yaohaoying-source/FreeRTOS-Weather-Station/docs/可靠性测试.md

# 可靠性测试记录

本文区分 **主机模拟** 和 **STM32 实板测试**。主机测试通过不等于真实模块、网络或长期运行已经通过。

## 1. 本次主机模拟

测试日期：2026-11-09。使用工程源码、虚拟串口和模拟队列；OneNET 主题使用占位值。

| 项目 | 模拟结果 | 覆盖内容 |
| --- | --- | --- |
| 属性和事件报文 | 通过 | 四组传感器 16 种有效/失效组合、缓冲区截断、事件 JSON |
| 平台回执 | 通过 | 主题和 ID 匹配、错误码、先回执后 OK、超时及计时回绕 |
| AT 和 DMA 接收 | 通过 | 无应答超时、已有旧 OK、异常回调、重启 DMA、超长行、重复发命令和其他任务访问 |
| 网络连接 | 通过 | 事件订阅失败、已有连接处理、状态行加 OK、状态查询超时 |
| 下发和队列 | 通过 | 下发与回执交错、下发队列满、离线丢弃旧下发 |
| 事件队列 | 通过 | 模拟容量 4、第五条丢弃计数、超时保留、延迟重试、成功回执后出队 |

上表中的队列和串口是测试桩；它不覆盖真实 DMA 时序、无线网络或 MCU 内存余量。

### 主机模拟的复现情况

上述模拟当时在 Windows 使用 Python 3.12.4、llvmlite 0.42.0 和 Keil Arm Compiler 6.22，从工程源码生成 LLVM IR 后运行。原测试脚本及测试桩已从当前仓库移除；此处保留历史结果，当前版本不能直接重复运行该组主机模拟。

## 2. Watch 观察量

任务栈的单位是 **word**，本工程 1 word = 4 字节；这些值是任务运行以来的历史最小剩余量，不是已用量。

| Watch 变量 | 含义 | 该任务分配的栈 |
| --- | --- | ---: |
| `g_stack_start_min_words` | 启动任务删除前测得的历史最小剩余 | 128 words / 512 B |
| `g_stack_sensor_min_words` | 采集任务历史最小剩余 | 384 words / 1536 B |
| `g_stack_display_min_words` | 显示任务历史最小剩余 | 512 words / 2048 B |
| `g_stack_network_min_words` | 网络任务历史最小剩余 | 512 words / 2048 B |
| `g_stack_idle_min_words` | 空闲任务历史最小剩余 | 128 words / 512 B |
| `g_heap_free_bytes` | FreeRTOS 堆当前空闲字节 | 配置总量 10240 B |
| `g_heap_min_free_bytes` | FreeRTOS 堆历史最小空闲字节 | 配置总量 10240 B |

例如读到 `g_stack_network_min_words = 100`，表示已覆盖的运行场景中历史最小剩余约 `100 × 4 = 400 B`。水位值依赖实际执行路径和写入情况，不能单凭一次正常运行就证明栈永远足够。FreeRTOS 任务栈通过其堆分配，不能把两者的已用量重复相加；中断使用的主栈也不包含在上述任务栈观察值中。启动任务会删除，因此只在删除前记录。

其他观察量：

- `g_air_recovery_attempts`：连接尝试次数，包含首次连接和恢复尝试。
- `g_air_reconnect_count`：在线状态转入恢复的次数。
- `g_air_at_failures`、`g_air_upload_timeouts`：AT 失败次数、属性回执超时次数。
- `g_air_uart_error_count`、`g_air_rx_restart_count`、`g_air_command_collision_count`：串口错误、接收重启和 AT 访问冲突次数。
- `g_cloud_set_received`、`g_cloud_set_applied`、`g_cloud_set_overflow`、`g_cloud_set_discarded`：属性下发接收、应用、队列满和恢复时丢弃次数。
- `g_pm25_event_queued`、`g_pm25_event_success`、`g_pm25_event_dropped`：超限事件入队、收到成功回执、队列满丢弃次数。
- `g_air_line_overflow`：超过单行容量时整行丢弃的次数；它**不代表** DMA 缓冲区覆盖次数。

## 3. 实板测试清单

以下按实际进度记录；未完成的场景仍需实测。每次记录开始和结束时间、供电方式、现象和 Watch 变量；不要把空白项写成通过。

| 测试 | 操作和预期 | 实际结果 |
| --- | --- | --- |
| 上电基线 | 正常上电；OLED 轮转，OneNET 周期更新；记录各栈水位和堆水位 | 部分确认：OLED 和 OneNET 上传正常，栈堆快照已记录；启动条件及运行时长待确认 |
| 单传感器失效 | 全部断电后移除 DHT11，再上电；温湿度本轮不上传，其他有效字段继续更新。断电后恢复接线并重新上电 | 通过（用户反馈，详细报文和时间未提供） |
| BMP280 断开与恢复 | 断电移除 BMP280 再上电，检查 OLED、其他数据及上报；断电接回后检查气压恢复 | 通过（用户反馈，详细报文和时间未提供） |
| 上报与下发同时发生 | 设备在线时，在上传时刻附近连续测试阈值和蜂鸣器开关；对照平台操作结果、OLED 与 `g_cloud_set_*` | 部分通过：用户反馈上传期间阈值下发及单独的蜂鸣器开关测试正常；严格重叠待验证 |
| 无应答 | 在安全断电条件下让模块不连接，再给 STM32 上电；采集和显示仍运行，网络连接尝试按间隔继续。恢复硬件连接前先断电 | 通过：重试数 1→3，OLED 如预期；接回并重启后 MQTT HAL_OK |
| 人工触发网络恢复 | Keil Watch 置位恢复请求，观察重连和上传 | 通过（用户反馈，具体计数和耗时未提供） |
| 断网后恢复 | 可通过 OneNET 停用/启用设备模拟平台强制下线，不重启 MCU；观察重连、平台上线和恢复上报。该方法不覆盖 4G 无线失网 | 通过（用户反馈按上述步骤恢复，具体计数和耗时未提供） |
| 队列满 | 先参考上面的主机模拟；若有可控的实板事件注入手段，再记录 `g_pm25_event_dropped` 和 `g_cloud_set_overflow` | 待测 |
| 持续运行 | 先至少连续运行 2 小时，进一步可做 24 小时；记录平台数据间隔、页面、错误计数、栈和堆水位 | 2 小时通过：用户确认未重启、云端持续更新、相关计数为 0，栈和堆稳定；24 小时待测 |

OneNET 对未上报的字段可能保留上一次值；验证部分上报时，要看其他字段的更新时间或上行报文，不能只看失效字段是否还显示旧值。模拟量模块断线不一定导致 ADC 返回错误，所以不要把 ADC 的 `HAL_OK` 当作传感器完好证明。

不建议带电插拔直插模块。若 4G 模块没有接 STM32 可控 RST，模块完全死机时软件不能保证自动复位；通用 AT 响应也缺乏命令编号，静默等待和状态查询只能降低迟到回复造成的歧义。发生此类情况需要人工复位或重启供电。

## 4. 实板记录

### 2026-11-10 云端蜂鸣器开关测试

- 测试内容：按非超限条件下云端开关 ON → OFF 的步骤，观察设备状态。
- 结果：用户反馈蜂鸣器开关测试通过；具体响应、截图和声音现象未单独提供。
- 本次记录不能替代超限条件下蜂鸣器发声及事件上报的重新验证。

### 2026-11-10 BMP280 断开与恢复

- 测试内容：按断电后移除 BMP280 的步骤，观察 OLED 气压异常显示、其他数据与上报；再断电接回并观察气压恢复。
- 结果：用户反馈“没有问题”，按用户反馈本轮通过；未提供具体数据、日志或时间。
- 本次只覆盖模块缺席和重新上电恢复，不代表 I²C 总线短路或运行中异常均已通过。

### 2026-11-10 上报期间阈值下发

- 测试内容：设备在线周期上报时，按提示在上报时间附近依次下发阈值 30 和 20，观察平台应答、OLED 和相关计数。
- 结果：用户反馈“没问题”；本轮具体日志、计数值和时间未提供。
- 结论：按用户反馈，本轮上下行业务配合测试通过。手动操作不能证明下发严格发生在某一笔上报等待回执的时间窗内；蜂鸣器下发不在本轮范围内。

### 2026-11-10 平台强制下线恢复

- 测试内容：OneNET 停用后启用设备，保持 MCU 运行，观察设备重新上线和恢复上报。
- 结果：用户反馈本轮按上述步骤测试通过；具体重连计数、恢复耗时和本轮日志未提供。
- 该测试模拟平台强制断开 MQTT 会话，不覆盖 SIM 卡或 4G 无线链路失网恢复。

### 2026-11-09 连续运行 2 小时

- 用户反馈：此前要求观察的重连、串口错误和属性上传超时计数均为 0；栈和堆的观察值与之前一致。
- 结论：2 小时稳定运行测试按用户反馈通过；24 小时运行、实际无线断网恢复和实板队列满仍未测试。
- 用户确认设备在没有重启的情况下连续运行已满 2 小时，OneNET 持续更新；精确起止时间及本轮新的栈、堆截图未提供。

### 2026-11-09 4G 模块无应答

- 用户断电取下模块后重新运行：截图中 `g_air_init_status = HAL_OK`、`g_air_mqtt_status = HAL_BUSY`，`g_air_recovery_attempts` 从 1 增至 3；用户反馈 OLED 表现符合预期。
- 断电接回模块并重新上电后：截图中 `g_air_recovery_attempts = 1`、`g_air_mqtt_status = HAL_OK`。计数器重启后重新计数。
- 结论：模块缺席时能继续重试且本地显示符合预期；接回模块重新上电后 MQTT 连接成功。截图未提供独立的 UP 回执详情。
- 该测试包含 MCU 断电重启，尚不能证明同一次运行中真实断网后自动恢复。

### 2026-11-09 人工触发网络恢复

- 测试内容：设备在线时，通过 Keil Watch 将 `g_air_recovery_requested` 置为 1，触发网络恢复流程。
- 结果：用户反馈测试通过；具体计数、状态值和恢复耗时未提供。
- 本次为主动触发恢复流程，不能替代模块无应答和实际断网后恢复的测试。

### 2026-11-09 单传感器失效测试

- 测试内容：断电移除 DHT11，检查其他有效数据能否继续上报，并在断电后恢复传感器。
- 结果：用户反馈上述测试通过；具体上传报文、数值和时间未提供。
- 此结果不代表网络无应答、实际断网重连或长时间运行测试已经通过。

### 2026-11-09 云端阈值下发

- 设备正常运行时，下发 `pm25_limit = 20`；用户确认设备端阈值修改成功。
- `g_cloud_set_received` 和 `g_cloud_set_applied` 相比操作前各增加 1。
- OneNET 于 16:13:53 返回外层 `code = 0`，设备响应 `code = 200`、`id = "4"`、`msg = "success"`。
- 结论：正常运行时的阈值下发和设备回复通过。没有取得下发与某次上传严格重叠的时间证据；蜂鸣器下发当时尚未单独验证，11 月 10 日用户反馈单独测试通过。

### 2026-11-09 Keil Watch 快照

来源：用户提供的两张 Keil Watch 截图。用户确认 OLED 页面及 OneNET 数据上传正常，运行时长尚未确认；本记录不代表故障注入或长期运行通过。

| 任务 | 分配栈（word） | 截图中的最小剩余栈（十六进制） | 剩余（word） | 剩余（B） |
| --- | ---: | ---: | ---: | ---: |
| Start | 128 | `0x4C` | 76 | 304 |
| Sensor | 384 | `0x13C` | 316 | 1264 |
| Display | 512 | `0x159` | 345 | 1380 |
| NetworkTask | 512 | `0x163` | 355 | 1420 |
| Idle | 128 | `0x74` | 116 | 464 |

| FreeRTOS 堆观察量 | 十六进制 | 字节 |
| --- | ---: | ---: |
| 当前空闲 | `0x928` | 2344 |
| 历史最小空闲 | `0x6C0` | 1728 |

初步结论：本次已执行场景下未看到任务栈或堆耗尽；暂不调整栈和堆配置。任务栈高水位只覆盖已执行并写入的路径，仍需在网络故障和长时间运行中复测。

- 测试日期和固件版本：
- 开始时间 / 结束时间 / 运行时长：
- 供电方式：
- 传感器失效与恢复：
- 网络中断与恢复：
- 下发、上报及事件：
- 最小剩余栈（Start / Sensor / Display / Network / Idle，单位 word）：
- 堆当前空闲 / 历史最小空闲（单位 byte）：
- 错误、溢出或丢弃计数：
- 结论与未解决现象：
