yaohaoying-source/FreeRTOS-Weather-Station/hardware/BOM.md

# 气象站物料清单

本清单按一套设备整理，分为 PCB 板级器件、整机模块与电源、调试安装配件。板级数据来自本地嘉立创 EDA 工程中的 PCB；保留原设计标注，未据此推断实物焊接值。外接模块及配件按作者提供的信息和现有资料整理。

## 一、PCB 板级器件

共 **22 个位号，14 组器件**。原始表格见 [EDA 导出 BOM](pcb-bom.xlsx)。已按位号、数量、标称值、封装及制造商/供应商字段与本地 EDA PCB 数据逐项核对。

| 位号 | 数量 | 工程标注 / 器件 | 封装 | 制造商型号 | 供应商编号 |
| --- | ---: | --- | --- | --- | --- |
| `BEEP1` | 1 | 2300Hz | `BUZ-TH_BD12.0-P7.60-D0.6-FD` | `TMB12A03` | `C96222` |
| `C2`、`C3` | 2 | 100nF | `C0805` | `CL21B104KBCNNNC` | `C1711` |
| `C6` | 1 | 100nF | `C0805` | `CC0805KRX7R9BB104` | `C49678` |
| `CN1` | 1 | DB128V-5.08-4P-GN-S | `CONN-TH_4P-P5.08_DIBO_DB128V-5.08` | `DB128V-5.08-4P-GN-S` | `C2915641` |
| `DC1` | 1 | DC-470-2.1GP | `DC-IN-TH_DC-470-2.1GP` | `DC-470-2.1GP` | `C194407` |
| `H19`、`H24` | 2 | PM254V-11-06-H85 | `HDR-TH_6P-P2.54-V-F` | `PM254V-11-06-H85` | `C2832269` |
| `H22` | 1 | PZ254V-11-03P | `HDR-TH_3P-P2.54-V-M` | `PZ254V-11-03P` | `C2937625` |
| `H5`、`H23`、`H25` | 3 | PM2.54-1*4 | `HDR-TH_4P-P2.54-V-F` | `PM2.54-1*4` | `C5116530` |
| `H6`、`H7` | 2 | PZ254V-11-02P | `HDR-TH_2P-P2.54-V-M` | `PZ254V-11-02P` | `C492401` |
| `P1` | 1 | 2.54-1*8P母环保 | `HDR-TH_8P-P2.54-V-F-1` | `2.54-1*8P母环保` | `C27438` |
| `R1`、`R3`、`R4` | 3 | 150Ω（料号冲突，待核对） | `R0805_NEW` | `0805W8F100JT5E` | 待核对 |
| `R2` | 1 | 10Ω | `R0805_NEW` | `0805W8F100JT5E` | `C17415` |
| `U1`、`U2` | 2 | KH-2.54FH-1X20P-H8.5 | `HDR-TH_20P-P2.54-V-F-2` | `KH-2.54FH-1X20P-H8.5` | `C2905423` |
| `U5` | 1 | ULN2003G-S16-R | `SOIC-16_L9.9-W3.9-P1.27-LS6.0-BL` | `ULN2003G-S16-R` | `C73286` |

> **待核对：** 原工程中 R1、R3、R4 的标称值为 150Ω，但关联的制造商型号与标称 10Ω 的 R2 相同；该型号对应的原工程器件属性也写为 10Ω。请按原理图和实际选型确认后再采购，当前未擅自修改。C2、C3 等数值均为工程标注，实物须另行核对。

## 二、整机模块、电源与连接配件

以下按一套设备列出；这些模块、电源及配件不属于上表的 22 个 PCB 板级位号。随模块附带的天线、线束等不必重复采购。

| 物料 | 数量 | 型号或说明 |
| --- | ---: | --- |
| 气象站 PCB 裸板 | 1 | 使用本目录的硬件工程制作；板级焊接器件见上表 |
| STM32 开发板 | 1 | STM32F103C8T6 最小系统板 |
| 温湿度模块 | 1 | DHT11，单总线 |
| 气压模块 | 1 | BMP280，I²C；设备曾读取到芯片 ID 0x58 |
| 光照模块 | 1 | 光敏电阻式模块，使用 AO 模拟输出；模块和芯片具体型号待确认 |
| 粉尘模块 | 1 | GP2Y1010 系列；此前提供型号 GP2Y1010AU0F，完整实物丝印待核对 |
| OLED 显示模块 | 1 | I²C OLED；程序按 128×64 配置，面板尺寸和控制器型号待确认 |
| 4G 通信模块 | 1 | 合宙 Air780E-B AT 版，转接板丝印 VIN / GND / RXD / TXD / DTR / RST / RDY |
| 风速传感器 | 1 | 聚碳三杯式风力测量仪；具体型号、量程、供电和输出信号待核对；当前 FreeRTOS 固件尚未实现风速采集 |
| 开关电源适配器 | 1 | 12V 1A；直流插头规格、极性及负载能力以实物为准 |
| 直流降压模块 | 1 | MINI560，项目使用 12V 转 5V；用户提供的标称输出为 5V 5A。两种称呼指同一块模块，不重复计数 |
| 4G 天线及配套射频线 | 1 套 | 根据转接板实际接口选择；若模块已附带则无需重复购买 |
| 4G 物联网 SIM 卡 | 1 | 需具备可用的移动网络服务；运营商及资费按实际选择 |
| 2.54 mm 跳线帽 | 2 个 | 对应原理图中的 H6、H7 串口跳线；按实际连接方式配备 |
| 传感器及供电连接线 | 1 套 | 按粉尘、风速及电源接口的实际插头和线序配备；随模块附带的线束不重复采购 |

风速硬件已列入清单，但当前 FreeRTOS 项目暂未实现风速采集、显示、上传和风速报警；旧版参考代码位于仓库的 `legacy/wind_sensor/`。

**供电能力：** MINI560 的 5A 是用户提供的模块标称值，并不代表本项目使用 12V 1A 适配器时可以输出 5V 5A：适配器标称功率约 12W，而 5V 5A 为 25W。转换损耗和其他负载会进一步影响可用功率，整机供电余量需按实际负载核对。

## 三、调试与安装辅助（按需）

| 物料 | 数量 | 用途 |
| --- | ---: | --- |
| ST-Link 调试器、USB 线及 SWD 连接线 | 1 套 | 烧录与调试；连接线按实际接口准备，建议按接口支持情况连接 NRST 复位线 |
| 固定支柱、螺钉等 | 按需 | 固定 PCB 和模块，规格依据实际结构选择 |

## 四、使用说明

- [本地 EDA 原工程](weather-station.epro) 与 [原理图 PDF](schematic.pdf) 为原工程资料；采购及焊接前应核对实际板卡、封装、电压和模块引脚。
- PCB 板级原始 BOM 导出自已打开的 PCB 页面，22 个位号、数量、标称值、封装和料号已与本地 EDA PCB 数据比对一致；这不等于实物、原理图、供货信息均已验证。
- PM2.5 目前使用旧公式计算，属于未标定的粉尘估算值；光照输出是相对百分比，不代表经过标定的 lux。
