yaohaoying-source/FreeRTOS-Weather-Station/hardware/pcb-bom.xlsx

No. | Quantity | Comment | Designator | Footprint | Value | Manufacturer Part | Manufacturer | Supplier Part | Supplier
1 | 1 | 2300Hz | BEEP1 | BUZ-TH_BD12.0-P7.60-D0.6-FD | 2300Hz | TMB12A03 | 华能 | C96222 | LCSC
2 | 2 | 100nF | C2,C3 | C0805 | 100nF | CL21B104KBCNNNC | SAMSUNG(三星) | C1711 | LCSC
3 | 1 | 100nF | C6 | C0805 | 100nF | CC0805KRX7R9BB104 | YAGEO(国巨) | C49678 | LCSC
4 | 1 | DB128V-5.08-4P-GN-S | CN1 | CONN-TH_4P-P5.08_DIBO_DB128V-5.08 |  | DB128V-5.08-4P-GN-S | DORABO(地博电气) | C2915641 | LCSC
5 | 1 | DC-470-2.1GP | DC1 | DC-IN-TH_DC-470-2.1GP |  | DC-470-2.1GP | GANGYUAN(港源) | C194407 | LCSC
6 | 3 | PM2.54-1*4 | H5,H23,H25 | HDR-TH_4P-P2.54-V-F |  | PM2.54-1*4 | ZHOURI(洲日) | C5116530 | LCSC
7 | 2 | PZ254V-11-02P | H6,H7 | HDR-TH_2P-P2.54-V-M |  | PZ254V-11-02P | XFCN(兴飞) | C492401 | LCSC
8 | 2 | PM254V-11-06-H85 | H19,H24 | HDR-TH_6P-P2.54-V-F |  | PM254V-11-06-H85 | XFCN(兴飞) | C2832269 | LCSC
9 | 1 | PZ254V-11-03P | H22 | HDR-TH_3P-P2.54-V-M |  | PZ254V-11-03P | XFCN(兴飞) | C2937625 | LCSC
10 | 1 | 2.54-1*8P母环保 | P1 | HDR-TH_8P-P2.54-V-F-1 |  | 2.54-1*8P母环保 | BOOMELE(博穆精密) | C27438 | LCSC
11 | 3 | 150Ω | R1,R3,R4 | R0805_NEW | 150Ω | 0805W8F100JT5E | UNI-ROYAL(厚声) |  | LCSC
12 | 1 | 10Ω | R2 | R0805_NEW | 10Ω | 0805W8F100JT5E | UNI-ROYAL(厚声) | C17415 | LCSC
13 | 2 | KH-2.54FH-1X20P-H8.5 | U1,U2 | HDR-TH_20P-P2.54-V-F-2 |  | KH-2.54FH-1X20P-H8.5 | kinghelm(金航标) | C2905423 | LCSC
14 | 1 | ULN2003G-S16-R | U5 | SOIC-16_L9.9-W3.9-P1.27-LS6.0-BL |  | ULN2003G-S16-R | UTC(友顺) | C73286 | LCSC
