yaohaoying-source/FreeRTOS-Weather-Station/hardware/schematic.pdf

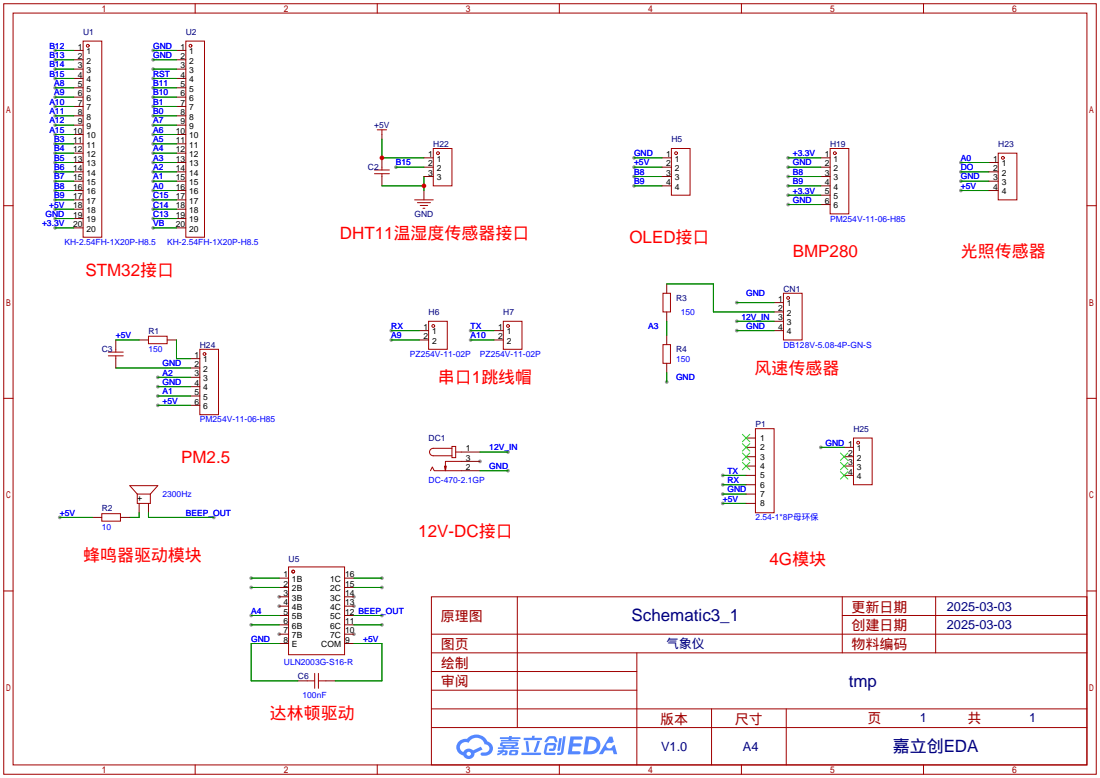
[picture p9: page 1]
