yaohaoying-source/FreeRTOS-Weather-Station/(list of files, drawings)

Other design files:
hardware/weather-station.epro
