yaohaoying-source/FreeRTOS-Weather-Station/Core/Inc/codetab.h

/**
  ******************************************************************************
  * @file    codetab.h
  * @author  fire
  * @version V1.0
  * @date    2014-xx-xx
  * @brief   128*64点阵的OLED显示测试工程，仅适用于SD1306驱动IIC通信方式显示屏
  ******************************************************************************
  * @attention  *
	* 
	* 1. 128*64点整OLED模块功能演示程序的字表，仅适用heltec.taobao.com所售产品;
	* 2. 字表由打包资料中的“取字软件”计算得出;
	* 3. 取字方式 -- 共阴、列行式、逆向输出
	*
  *
  ******************************************************************************
  */ 
#ifndef __CODETAB_H
#define	__CODETAB_H


/***************************16*16的点阵字体取模方式：共阴——列行式——逆向输出*********/

/************************************6*8的点阵************************************/
const unsigned char F6x8[][6] =
{
	0x00, 0x00, 0x00, 0x00, 0x00, 0x00,// sp
	0x00, 0x00, 0x00, 0x2f, 0x00, 0x00,// !
	0x00, 0x00, 0x07, 0x00, 0x07, 0x00,// "
	0x00, 0x14, 0x7f, 0x14, 0x7f, 0x14,// #
	0x00, 0x24, 0x2a, 0x7f, 0x2a, 0x12,// $
	0x00, 0x62, 0x64, 0x08, 0x13, 0x23,// %
	0x00, 0x36, 0x49, 0x55, 0x22, 0x50,// &
	0x00, 0x00, 0x05, 0x03, 0x00, 0x00,// '
	0x00, 0x00, 0x1c, 0x22, 0x41, 0x00,// (
	0x00, 0x00, 0x41, 0x22, 0x1c, 0x00,// )
	0x00, 0x14, 0x08, 0x3E, 0x08, 0x14,// *
	0x00, 0x08, 0x08, 0x3E, 0x08, 0x08,// +
	0x00, 0x00, 0x00, 0xA0, 0x60, 0x00,// ,
	0x00, 0x08, 0x08, 0x08, 0x08, 0x08,// -
	0x00, 0x00, 0x60, 0x60, 0x00, 0x00,// .
	0x00, 0x20, 0x10, 0x08, 0x04, 0x02,// /
	0x00, 0x3E, 0x51, 0x49, 0x45, 0x3E,// 0
	0x00, 0x00, 0x42, 0x7F, 0x40, 0x00,// 1
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
};
const unsigned char F[][16] = {
	0x70,0x88,0xF8,0x40,0xE0,0x18,0x00,0x00,0x00,0x30,0x0C,0x03,0x1E,0x21,0x3F,0x00,
	0x00,0x00,0x00,0x00,0x00,0x00,0x00,0x00,0x00,0x00,0x00,0x00,0x00,0x00,0x00,0x00/*"%",0*/
};

#endif
