yaohaoying-source/FreeRTOS-Weather-Station/Core/Src/adc.c

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
/* Includes ------------------------------------------------------------------*/
#include "adc.h"

ADC_HandleTypeDef hadc1;

/* ADC1 init function */
void MX_ADC1_Init(void)
{

  ADC_ChannelConfTypeDef sConfig = {0};

  /** Common config
  */
  hadc1.Instance = ADC1;
  hadc1.Init.ScanConvMode = ADC_SCAN_DISABLE;
  hadc1.Init.ContinuousConvMode = DISABLE;
  hadc1.Init.DiscontinuousConvMode = DISABLE;
  hadc1.Init.ExternalTrigConv = ADC_SOFTWARE_START;
  hadc1.Init.DataAlign = ADC_DATAALIGN_RIGHT;
  hadc1.Init.NbrOfConversion = 1;
  if (HAL_ADC_Init(&hadc1) != HAL_OK)
  {
    Error_Handler();
  }

  /** Configure Regular Channel
  */
  sConfig.Channel = ADC_CHANNEL_0;
  sConfig.Rank = ADC_REGULAR_RANK_1;
  sConfig.SamplingTime = ADC_SAMPLETIME_1CYCLE_5;
  if (HAL_ADC_ConfigChannel(&hadc1, &sConfig) != HAL_OK)
  {
    Error_Handler();
  }
}

void HAL_ADC_MspInit(ADC_HandleTypeDef* adcHandle)
{

  GPIO_InitTypeDef GPIO_InitStruct = {0};
  if(adcHandle->Instance==ADC1)
  {
    /* ADC1 clock enable */
    __HAL_RCC_ADC1_CLK_ENABLE();

    __HAL_RCC_GPIOA_CLK_ENABLE();
    /**ADC1 GPIO Configuration
    PA0-WKUP     ------> ADC1_IN0
    PA1     ------> ADC1_IN1
    PA3     ------> ADC1_IN3
    */
    GPIO_InitStruct.Pin = GPIO_PIN_0|GPIO_PIN_1|GPIO_PIN_3;
    GPIO_InitStruct.Mode = GPIO_MODE_ANALOG;
    HAL_GPIO_Init(GPIOA, &GPIO_InitStruct);

  }
}

void HAL_ADC_MspDeInit(ADC_HandleTypeDef* adcHandle)
{

  if(adcHandle->Instance==ADC1)
  {
    /* Peripheral clock disable */
    __HAL_RCC_ADC1_CLK_DISABLE();

    /**ADC1 GPIO Configuration
    PA0-WKUP     ------> ADC1_IN0
    PA1     ------> ADC1_IN1
    PA3     ------> ADC1_IN3
    */
    HAL_GPIO_DeInit(GPIOA, GPIO_PIN_0|GPIO_PIN_1|GPIO_PIN_3);

  }
}

/* USER CODE BEGIN 1 */
  HAL_StatusTypeDef ADC_ReadAverage(uint32_t channel,uint8_t times,uint16_t *value)
  {
    ADC_ChannelConfTypeDef config = {0};
    HAL_StatusTypeDef status;
    uint32_t sum = 0;

    if(times == 0||value == NULL) return HAL_ERROR;

    config.Channel = channel;
    config.Rank = ADC_REGULAR_RANK_1;
    config.SamplingTime = ADC_SAMPLETIME_239CYCLES_5;
    
    status = HAL_ADC_ConfigChannel(&hadc1,&config);
    if(status != HAL_OK) return status;

    for(uint8_t i = 0; i < times; i++)
    {
      status = HAL_ADC_Start(&hadc1);
      if(status != HAL_OK)
      {
        return status;
      }
      status = HAL_ADC_PollForConversion(&hadc1, 10);
      if(status != HAL_OK)
      {
        HAL_ADC_Stop(&hadc1);
        return status;
      }
      sum += HAL_ADC_GetValue(&hadc1);
      status = HAL_ADC_Stop(&hadc1);
      if(status != HAL_OK)
      {
        return status;
      }      
    }
    * value = (uint16_t)(sum / times);
    return HAL_OK;
  }

/* USER CODE END 1 */
