yaohaoying-source/FreeRTOS-Weather-Station/Core/Inc/onenet_config.local.example.h

#ifndef ONENET_CONFIG_LOCAL_H
#define ONENET_CONFIG_LOCAL_H

/*
 * 将本文件复制为 onenet_config.local.h，再填入自己的设备信息。
 * onenet_config.local.h 已被 .gitignore 排除，不要提交到仓库。
 */
#define ONENET_PRODUCT_ID   "YOUR_PRODUCT_ID"
#define ONENET_DEVICE_NAME  "YOUR_DEVICE_NAME"
#define ONENET_TOKEN        "YOUR_DEVICE_TOKEN"

#endif
